railbox/WMouse/Mouse/Mouse_bom_.csv

Component | Description | References | Value | Footprint | Quantity Per PCB
1 | Unpolarized capacitor | C6 C8 | 0.1u | C_0805_2012Metric_Pad1.15x1.40mm_HandSolder | 2
2 | Unpolarized capacitor | C5 C9-C10 | 10u | C_0805_2012Metric_Pad1.15x1.40mm_HandSolder | 3
3 | Unpolarized capacitor | C3-C4 C7 | 1u | C_0805_2012Metric_Pad1.15x1.40mm_HandSolder | 3
4 | Unpolarized capacitor | C1-C2 | 2.2u | C_0805_2012Metric_Pad1.15x1.40mm_HandSolder | 2
5 |  | D1 | OLED32pin | OLED_32pin | 1
6 | Inductor | L1 | 4.7uH | L_1210_3225Metric_Pad1.42x2.65mm_HandSolder | 1
7 | 50V Vds, 0.22A Id, N-Channel MOSFET, SOT-23 | Q2 | IRLML2060 | SOT-23_Handsoldering | 1
8 | 0.8A Ic, 45V Vce, NPN Transistor, SOT-23 | Q1 | MMBT3904 | SOT-23_Handsoldering | 1
9 | Resistor | R17 | 0 | R_0805_2012Metric_Pad1.15x1.40mm_HandSolder | 1
10 | Resistor | R9-R11 | 100k | R_0805_2012Metric_Pad1.15x1.40mm_HandSolder | 3
11 | Resistor | R3-R5 | 10k | R_0805_2012Metric_Pad1.15x1.40mm_HandSolder | 3
12 | Resistor | R1 R14 | 1M | R_0805_2012Metric_Pad1.15x1.40mm_HandSolder | 2
13 | Resistor | R8 | 2k | R_0805_2012Metric_Pad1.15x1.40mm_HandSolder | 1
14 | Resistor | R2 R12-R13 | 470k | R_0805_2012Metric_Pad1.15x1.40mm_HandSolder | 3
15 | Single NOT Gate, Low-Voltage CMOS | U2 | 74AHC1G04 | SOT-23-5_HandSoldering | 1
16 | 802.11 b/g/n Wi-Fi Module | U1 | ESP-12E | ESP-12E | 1
17 | DC-DC Step-up converter, constant frequency, 6-pin SOT23 | U3 | MT3608 | SOT-23-6 | 1
Component Groups: | 17
Component Count: | 30
Fitted Components: | 30
Number of PCBs: | 1
Total components: | 30
Schematic Version:
Schematic Date:
BoM Date: | 18.09.2020 15:21:41
Schematic Source: | C:\Users\Toxa\YandexDisk\PROGRAMMING\Modules_with_MCU\WMouse\_hardware\Mouse\Mouse.sch
KiCad Version: | Eeschema (5.1.5)-3
