railbox/WMouse/Mouse/Mouse.kicad_pcb

## KiCad design Mouse/Mouse.kicad_pcb (2020-09-18)

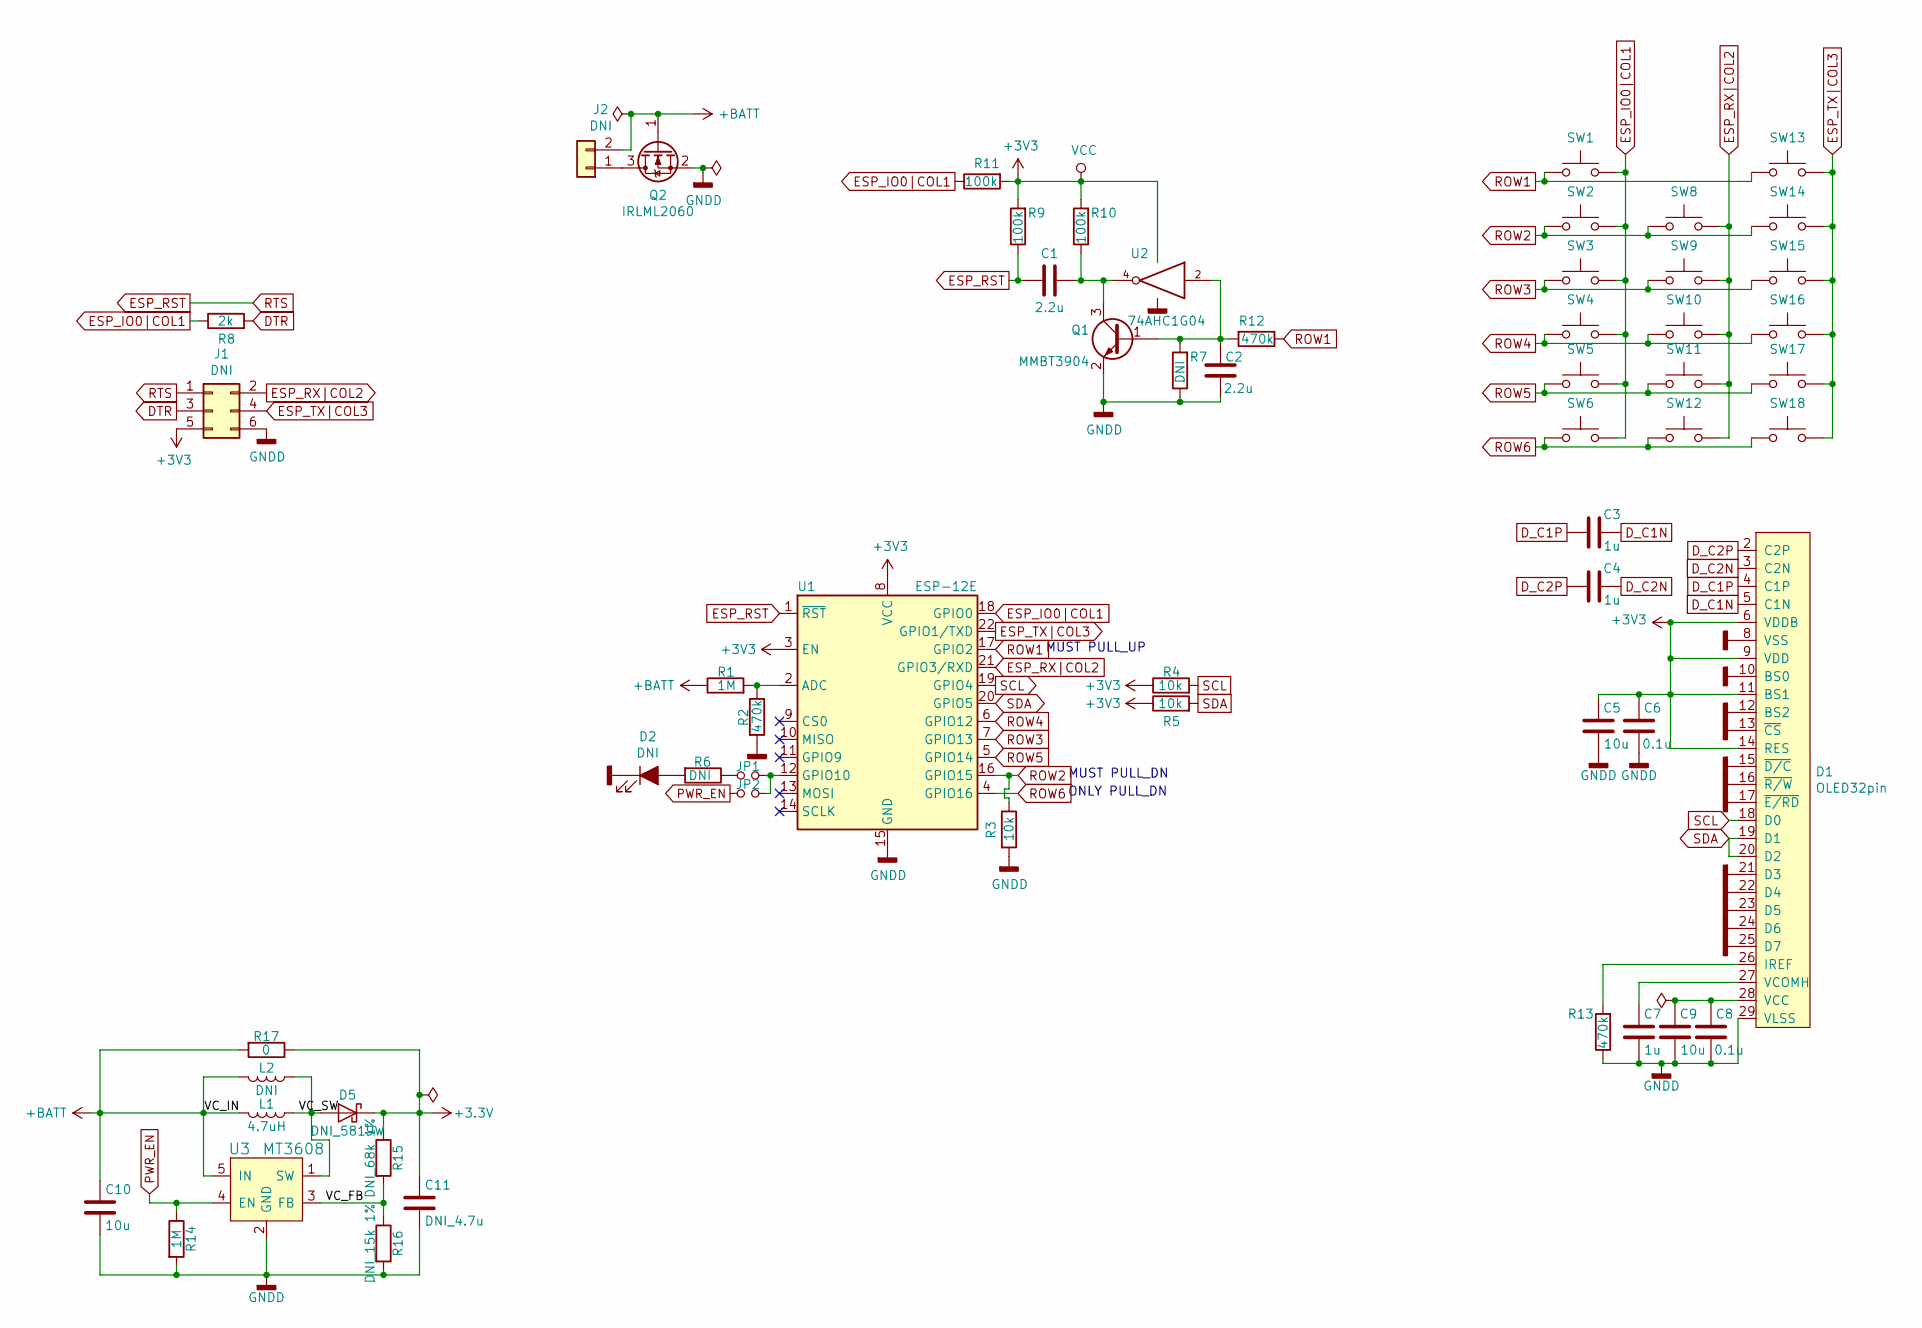
[picture p3: schematic Mouse.sch]

Parts:
C1, C2: 2.2u; C_0805_2012Metric_Pad1.15x1.40mm_HandSolder
C3, C4, C7: 1u; C_0805_2012Metric_Pad1.15x1.40mm_HandSolder
C5, C9, C10: 10u; C_0805_2012Metric_Pad1.15x1.40mm_HandSolder
C6, C8: 0.1u; C_0805_2012Metric_Pad1.15x1.40mm_HandSolder
C11: DNI_4.7u; C_0805_2012Metric_Pad1.15x1.40mm_HandSolder
D1: OLED32pin; OLED_32pin
D2: DNI; LED_D5.0mm_Horizontal_O3.81mm_Z3.0mm
D5: DNI_5819W; D_SOD-123
J1: DNI; PinHeader_2x03_P2.54mm_Vertical
J2: DNI; RC_case
JP1, JP2: DNI; SolderJumper-2_P1.3mm_Open_TrianglePad1.0x1.5mm
L1: 4.7uH; L_1210_3225Metric_Pad1.42x2.65mm_HandSolder
L2: DNI; L_1812_4532Metric
Q1: MMBT3904; SOT-23_Handsoldering
Q2: IRLML2060; SOT-23_Handsoldering
R1, R14: 1M; R_0805_2012Metric_Pad1.15x1.40mm_HandSolder
R2, R12, R13: 470k; R_0805_2012Metric_Pad1.15x1.40mm_HandSolder
R3, R4, R5: 10k; R_0805_2012Metric_Pad1.15x1.40mm_HandSolder
R6, R7: DNI; R_0805_2012Metric_Pad1.15x1.40mm_HandSolder
R8: 2k; R_0805_2012Metric_Pad1.15x1.40mm_HandSolder
R9, R10, R11: 100k; R_0805_2012Metric_Pad1.15x1.40mm_HandSolder
R15: DNI_68k 1%; R_0805_2012Metric_Pad1.15x1.40mm_HandSolder
R16: DNI_15k 1%; R_0805_2012Metric_Pad1.15x1.40mm_HandSolder
R17: 0; R_0805_2012Metric_Pad1.15x1.40mm_HandSolder
SW1: DNI_PCB; RC_button_long
SW2, SW3, SW4, SW5, SW6, SW8, SW9, SW10, SW11, SW12, SW13, SW14, SW15, SW16, SW17, SW18: DNI_PCB; RC_button
U1: ESP-12E
U2: 74AHC1G04; SOT-23-5_HandSoldering
U3: MT3608; SOT-23-6

Connections:
+BATT: C10.1, J2.2, L1.2, L2.2, Q2.1 (G), R1.1, R17.2, U3.5 (IN)
/VC_FB: R15.2, R16.1, U3.3 (FB)
/VC_SW: D5.2 (A), L1.1, L2.1, U3.1 (SW)
DTR: J1.3, R8.2
D_C1N: C3.1, D1.5 (C1N)
D_C1P: C3.2, D1.4 (C1P)
D_C2N: C4.1, D1.3 (C2N)
D_C2P: C4.2, D1.2 (C2P)
ESP_IO0|COL1: R8.1, R11.1, SW1.2, SW2.2, SW3.2, SW4.2, SW5.2, SW6.2, U1.18 (GPIO0)
ESP_RST: C1.1, J1.1, R9.1, U1.1 (~RST)
ESP_RX|COL2: J1.2, SW8.2, SW9.2, SW10.2, SW11.2, SW12.2, U1.21 (GPIO3/RXD)
ESP_TX|COL3: J1.4, SW13.2, SW14.2, SW15.2, SW16.2, SW17.2, SW18.2, U1.22 (GPIO1/TXD)
GND: C2.1, C5.1, C6.1, C7.1, C8.1, C9.1, C10.2, C11.2, D1.8 (VSS), D1.10 (BS0), D1.12 (BS2), D1.13 (~CS), D1.15 (~D/C), D1.16 (~R/W), D1.17 (~E/RD), D1.21 (D3), D1.22 (D4), D1.23 (D5), D1.24 (D6), D1.25 (D7), D1.29 (VLSS), D2.1 (K), J1.6, Q1.2 (E), Q2.2 (S), R2.2, R3.2, R7.1, R13.1, R14.2, R16.2, U1.15 (GND), U2.3 (GND), U3.2 (GND)
unnamed: C1.2, Q1.3 (C), R10.1, U2.4
unnamed: C2.2, Q1.1 (B), R7.2, R12.2, U2.2
unnamed: C7.2, D1.27 (VCOMH)
unnamed: C8.2, C9.2, D1.28 (VCC)
unnamed: D1.26 (IREF), R13.2
unnamed: D2.2 (A), R6.2
unnamed: J2.1, Q2.3 (D)
unnamed: JP1.1, R6.1
unnamed: JP1.2, JP2.2, U1.12 (GPIO10)
unnamed: R1.2, R2.1, U1.2 (ADC)
PWR_EN: JP2.1, R14.1, U3.4 (EN)
ROW1: R12.1, SW1.1, SW13.1, U1.17 (GPIO2)
ROW2: R3.1, SW2.1, SW8.1, SW14.1, U1.16 (GPIO15)
ROW3: SW3.1, SW9.1, SW15.1, U1.7 (GPIO13)
ROW4: SW4.1, SW10.1, SW16.1, U1.6 (GPIO12)
ROW5: SW5.1, SW11.1, SW17.1, U1.5 (GPIO14)
ROW6: SW6.1, SW12.1, SW18.1, U1.4 (GPIO16)
SCL: D1.18 (D0), R4.2, U1.19 (GPIO4)
SDA: D1.19 (D1), D1.20 (D2), R5.2, U1.20 (GPIO5)

Notes on the sheet:
MUST PULL_UP
MUST PULL_DN
ONLY PULL_DN

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
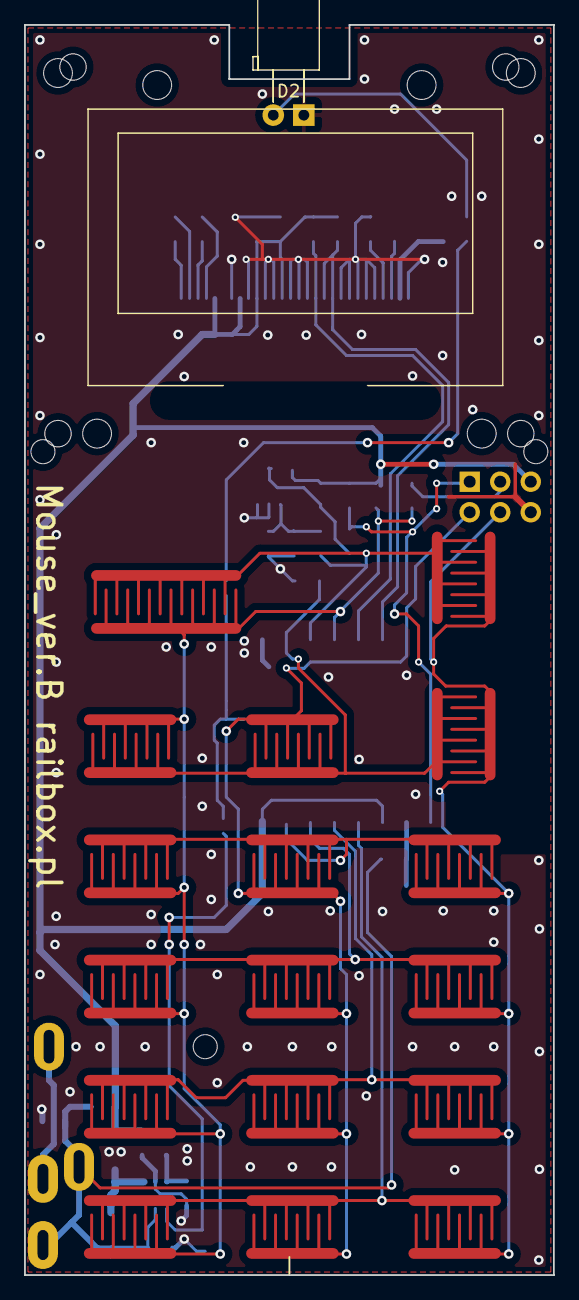
[picture p4: board Mouse.kicad_pcb from above]

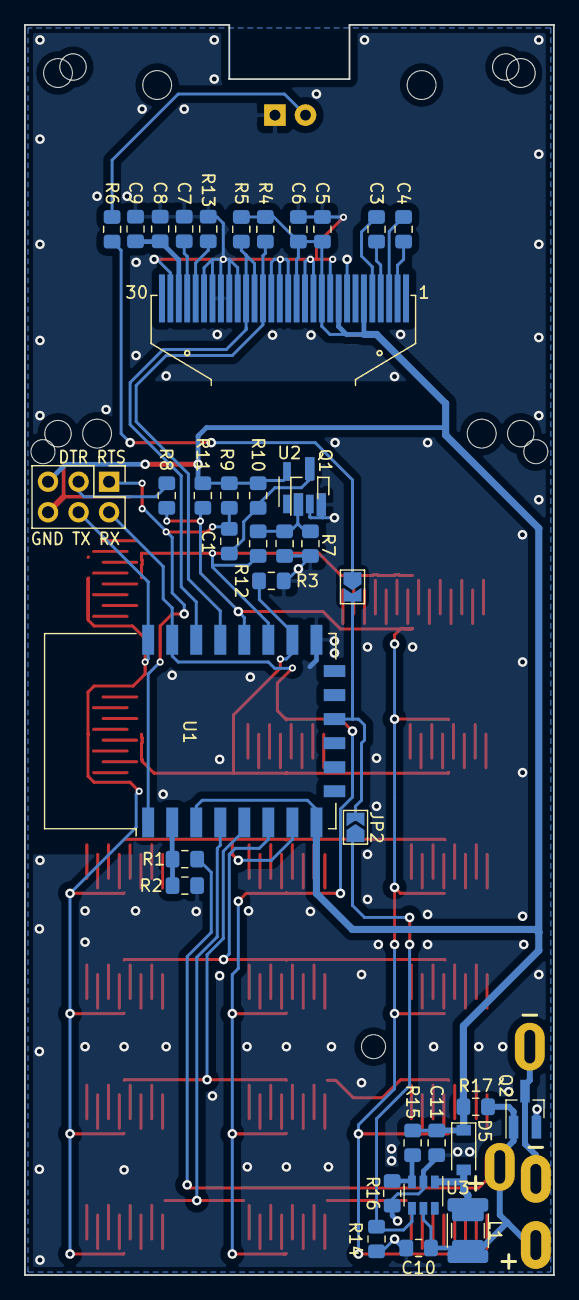
[picture p5: board Mouse.kicad_pcb from below]

Board: 2 copper layers, 44.0 x 104.0 mm, 59 parts (39 on the bottom side), 33 nets.
