railbox/WMouse/src/img.h

/* 
 * This file is part of the WMouse distribution https://github.com/railbox/WMouse.
 * Copyright (c) 2020 Anton Nadezhdin.
 * 
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
 * You should have received a copy of the GNU General Public License 
 * along with this program. If not, see <http://www.gnu.org/licenses/>.
 */
#include "stdint.h"

#ifndef PROGMEM
#define PROGMEM
#endif

typedef struct {
	uint8_t width;
	uint8_t height;
	uint8_t data[];
}bitmap_t;

static bitmap_t PROGMEM ant = { 9, 20, {
	0x10, 0x00, 0x11, 0x01, 0x11, 0x01, 0x92, 0x00, 0x92, 0x00, 0x54, 0x00,
	0x54, 0x00, 0x38, 0x00, 0x38, 0x00, 0x10, 0x00, 0x10, 0x00, 0x10, 0x00,
	0x10, 0x00, 0x10, 0x00, 0x10, 0x00, 0x10, 0x00, 0x10, 0x00, 0x10, 0x00,
	0x10, 0x00, 0x10, 0x00, }
	};
static bitmap_t PROGMEM bat = { 16, 7, {
	0xFE, 0xFF, 0x02, 0x80, 0x03, 0x80, 0x03, 0x80, 0x03, 0x80, 0x02, 0x80,
	0xFE, 0xFF, }
	};
static bitmap_t PROGMEM left = { 6, 11, {
	0x20, 0x30, 0x38, 0x3C, 0x3E, 0x3F, 0x3E, 0x3C, 0x38, 0x30, 0x20, }
	};
static bitmap_t PROGMEM light = { 9, 9, {
	0x10, 0x00, 0x92, 0x00, 0x54, 0x00, 0x38, 0x00, 0xFF, 0x01, 0x38, 0x00,
	0x54, 0x00, 0x92, 0x00, 0x10, 0x00, }
	};
static bitmap_t PROGMEM logo = { 128, 53, {
  0x00, 0x00, 0x00, 0x3C, 0x00, 0x00, 0x00, 0x00, 0x00, 0x00, 0x00, 0x00,
  0x00, 0x00, 0x00, 0x00, 0x00, 0x00, 0x00, 0xFF, 0x00, 0x00, 0x00, 0x00,
  0x00, 0x00, 0x00, 0x00, 0x00, 0x00, 0x00, 0x00, 0x00, 0x00, 0xC0, 0xE3,
  0x03, 0x00, 0x00, 0x00, 0x00, 0x00, 0x00, 0x00, 0x00, 0x00, 0x00, 0x00,
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
	0x00, 0xFC, 0x1F, 0x00, 0x80, 0xFF, 0x0F, 0x00, 0xF8, 0xFF, 0x07, 0x00,
	0xFF, 0xFF, 0x03, 0x00, 0xFF, 0xFF, 0x01, 0x00, 0xFF, 0xFF, 0x00, 0x00,
	0xFF, 0x7F, 0x00, 0x00, 0xFF, 0x1F, 0x00, 0x00, 0xFF, 0x07, 0x00, 0x00,
	0xFF, 0x01, 0x00, 0x00, 0x3F, 0x00, 0x00, 0x00, }
	};
