railbox/WMouse/src/update_server.cpp

/* 
 * This file is part of the WMouse distribution https://github.com/railbox/WMouse.
 * Copyright (c) 2020 Anton Nadezhdin.
 * 
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
 * You should have received a copy of the GNU General Public License 
 * along with this program. If not, see <http://www.gnu.org/licenses/>.
 */
#include <Arduino.h>
#include <WiFiClient.h>
#include <WiFiServer.h>
#include <ESP8266WebServer.h>
#include <WiFiUdp.h>
#include <EEPROM.h>
#include "StreamString.h"
#include "update_server.h"
#include "config.h"

#define BINARY_NAME_PREFIX  "WMouse_ESP_"

#ifndef ATOMIC_FS_UPDATE
#error "Please define ATOMIC_FS_UPDATE in the project"
#endif

static const char serverIndex[] PROGMEM =
  R"(<html><body><title>RailBOX Firmware update</title><h2>RailBOX Firmware update</h2><form method='POST' action='' enctype='multipart/form-data'>
                  <input type='file' name='update'>
                  <input type='submit' value='Update'>
               </form>
         </body></html>)";
static const char successResponse[] PROGMEM = 
  "<META http-equiv=\"refresh\" content=\"15;URL=/\">Update Success! Rebooting...\n";

ESP8266HTTPUpdateServer::ESP8266HTTPUpdateServer(bool serial_debug, notification_handler_t notification_handler)
{
  _notification_handler = notification_handler;
  _serial_output = serial_debug;
  _server = NULL;
  _username = emptyString;
  _password = emptyString;
  _authenticated = false;
}

void ESP8266HTTPUpdateServer::setup(ESP8266WebServer *server, const String& path, const String& username, const String& password)
{
    _server = server;
    _username = username;
    _password = password;

    // handler for the /update form page
    _server->on(path.c_str(), HTTP_GET, [&](){
      if(_username != emptyString && _password != emptyString && !_server->authenticate(_username.c_str(), _password.c_str()))
        return _server->requestAuthentication();
      _server->send_P(200, PSTR("text/html"), serverIndex);
    });

    // handler for the /update form POST (once file upload finishes)
    _server->on(path.c_str(), HTTP_POST, [&](){
      if(!_authenticated)
        return _server->requestAuthentication();
      if (Update.hasError()) {
        _server->send(200, F("text/html"), String(F("Update error: ")) + _updaterError);
      } else {
        _server->client().setNoDelay(true);
        _server->send_P(200, PSTR("text/html"), successResponse);
        delay(100);
        _server->client().stop();
        if (_notification_handler) _notification_handler(FW_UPDATE_RESTART);
        else {
          WiFi.forceSleepBegin();
          delay(100);
          ESP.restart();
        }
      }
    },[&](){
      // handler for the file upload, get's the sketch bytes, and writes
      // them through the Update object
      HTTPUpload& upload = _server->upload();

      if(upload.status == UPLOAD_FILE_START){
        _updaterError = String();
        if (_serial_output)
          Serial.setDebugOutput(true);

        if (strncmp(upload.filename.c_str(), BINARY_NAME_PREFIX, sizeof(BINARY_NAME_PREFIX)-1)) {
          _server->send(200, F("text/html"), String(F("Wrong file provided")));
          return;
        }

        _authenticated = (_username == emptyString || _password == emptyString || _server->authenticate(_username.c_str(), _password.c_str()));
        if(!_authenticated){
          if (_serial_output)
            Serial.printf("Unauthenticated Update\n");
          return;
        }

        if (_notification_handler) _notification_handler(FW_UPDATE_START);
        WiFiUDP::stopAll();
        if (_serial_output)
          Serial.printf("Update: %s\n", upload.filename.c_str());
        uint32_t maxSketchSpace = (ESP.getFreeSketchSpace() - 0x1000) & 0xFFFFF000;
        if(!Update.begin(maxSketchSpace)){//start with max available size
          _setUpdaterError();
        }
      } else if(_authenticated && upload.status == UPLOAD_FILE_WRITE && !_updaterError.length()){
        if (_serial_output) Serial.printf(".");
        if(Update.write(upload.buf, upload.currentSize) != upload.currentSize){
          _setUpdaterError();
        }
      } else if(_authenticated && upload.status == UPLOAD_FILE_END && !_updaterError.length()){
        if(Update.end(true)){ //true to set the size to the current progress
          if (_notification_handler) _notification_handler(FW_UPDATE_FINISH);
          if (_serial_output) Serial.printf("Update Success: %u\nRebooting...\n", upload.totalSize);
        } else {
          _setUpdaterError();
        }
        if (_serial_output) Serial.setDebugOutput(false);
      } else if(_authenticated && upload.status == UPLOAD_FILE_ABORTED){
        Update.end();
        if (_serial_output) Serial.println("Update was aborted");
      }
      delay(0);
    });
}

void ESP8266HTTPUpdateServer::_setUpdaterError()
{
  if (_serial_output) Update.printError(Serial);
  StreamString str;
  Update.printError(str);
  _updaterError = str.c_str();
}
