railbox/WMouse/(commit log)

2020-09-18 Add hardware files
    [Mouse.kicad_pcb, Mouse.sch, Mouse_bom_.csv]
2020-12-08 Fix bug with maximum speed and increase loco speed steps
    [config.h, lcd_hl.c, main_page.c]
